Eliezer-Davidson/DS4DOCK/stl/faceplate/faceplate_full.stl

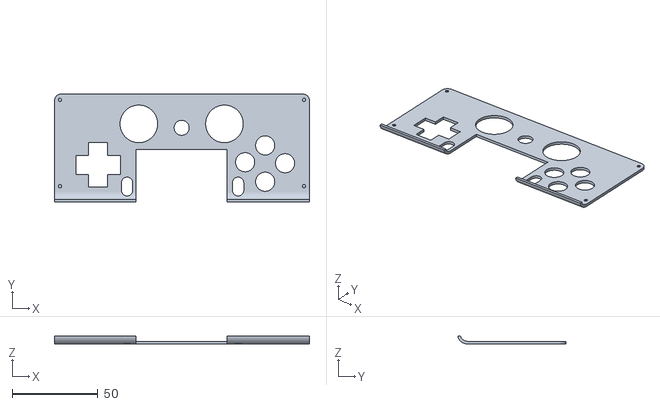
[picture p7: CAD file, 2026-10-22]
stl/faceplate/faceplate_full.stl
149.0 x 63.2 x 4.82
