Eliezer-Davidson/DS4DOCK/stl/caps/stick_cap_loose.stl

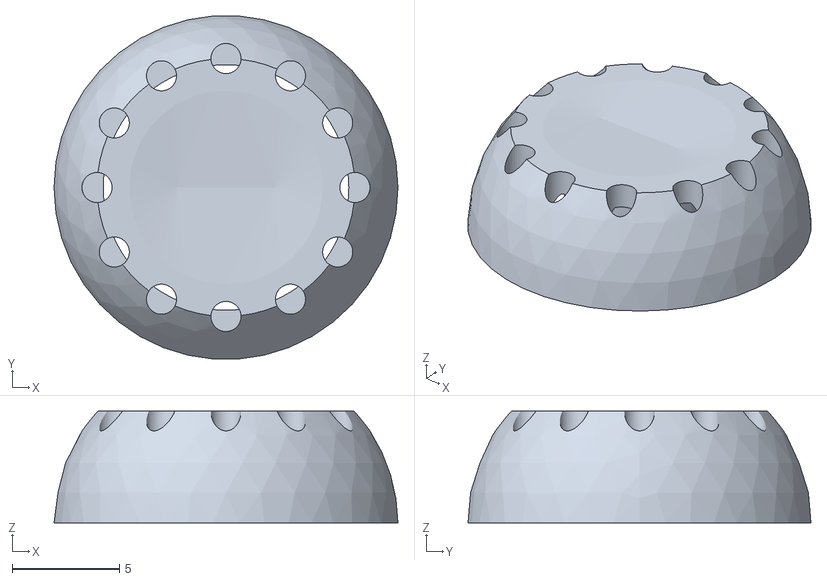
[picture p8: CAD file, 2026-10-22]
stl/caps/stick_cap_loose.stl
16.0 x 16.0 x 5.20
