Eliezer-Davidson/DS4DOCK/stl/cradle/cradle_std_nohook.stl

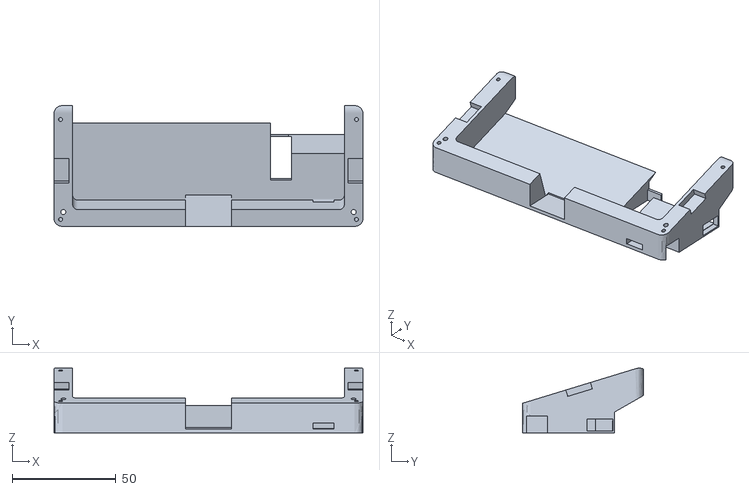
[picture p9: CAD file, 2026-10-22]
stl/cradle/cradle_std_nohook.stl
149.0 x 58.2 x 31.2
