Eliezer-Davidson/DS4DOCK/stl/extenders/right1_base_std_nohook.stl

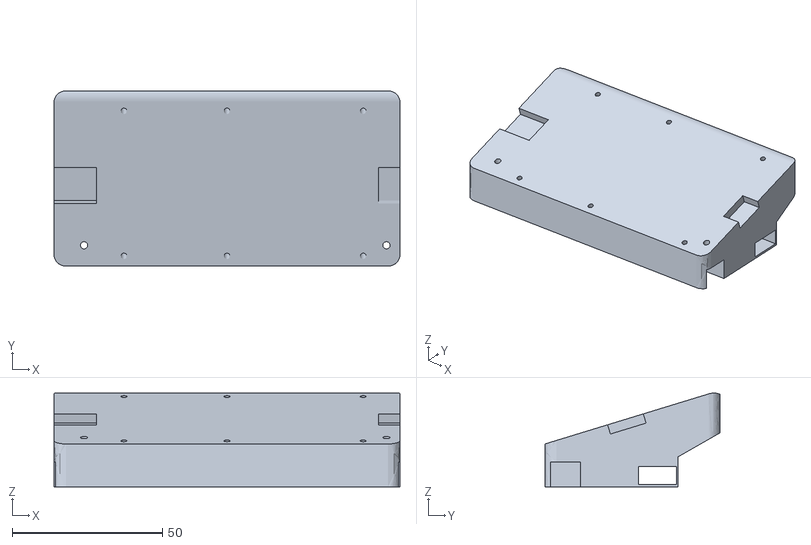
[picture p10: CAD file, 2026-10-22]
stl/extenders/right1_base_std_nohook.stl
115.0 x 58.2 x 31.2
