Eliezer-Davidson/DS4DOCK/stl/joint/topkey.stl

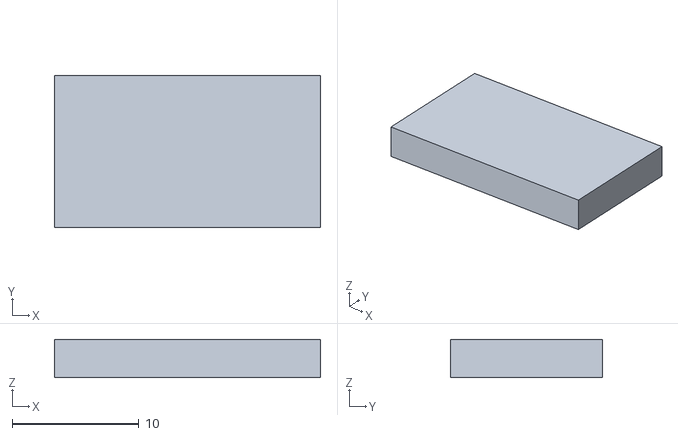
[picture p11: CAD file, 2026-10-22]
stl/joint/topkey.stl
21.0 x 12.0 x 3.00
