Eliezer-Davidson/DS4DOCK/stl/cradle/cradle_std_hook.stl

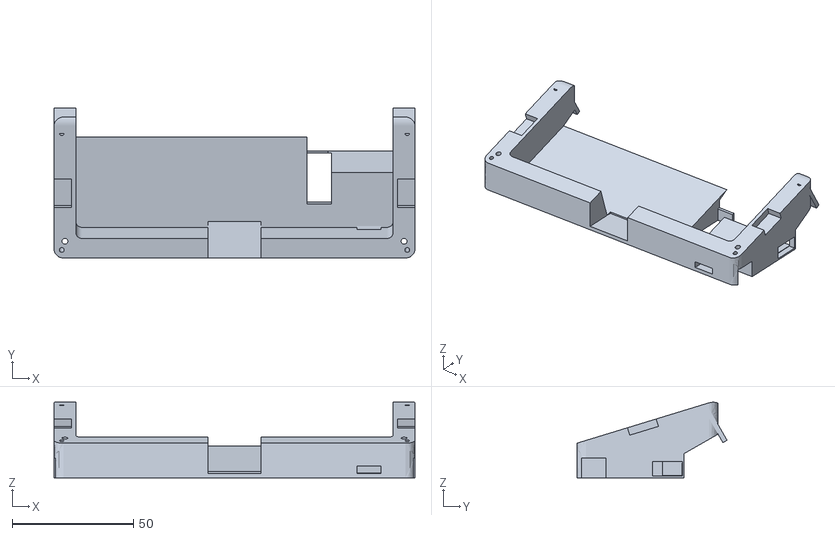
[picture p12: CAD file, 2026-10-22]
stl/cradle/cradle_std_hook.stl
149.0 x 62.0 x 31.2
