Eliezer-Davidson/DS4DOCK/stl/extenders/left_base_low_hook.stl

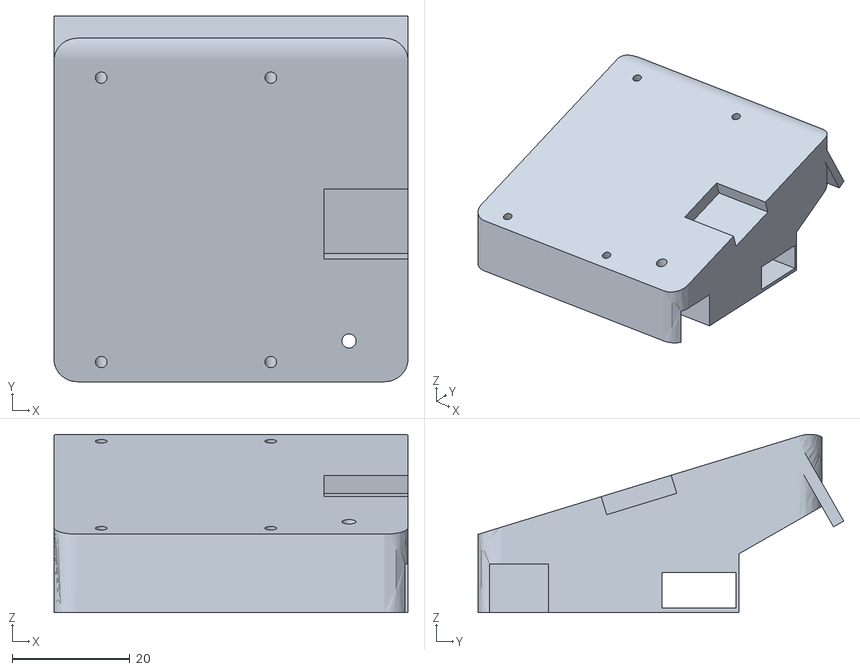
[picture p13: CAD file, 2026-10-22]
stl/extenders/left_base_low_hook.stl
60.0 x 62.0 x 30.2
