Eliezer-Davidson/DS4DOCK/stl/joint/spline.stl

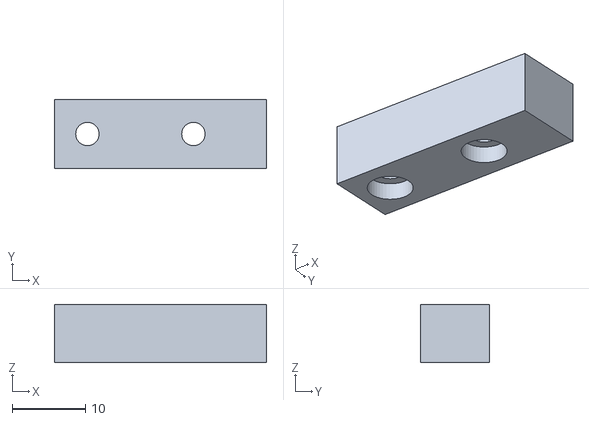
[picture p15: CAD file, 2026-10-22]
stl/joint/spline.stl
29.0 x 9.50 x 8.00
