Eliezer-Davidson/DS4DOCK/stl/cradle/cradle_low_hook.stl

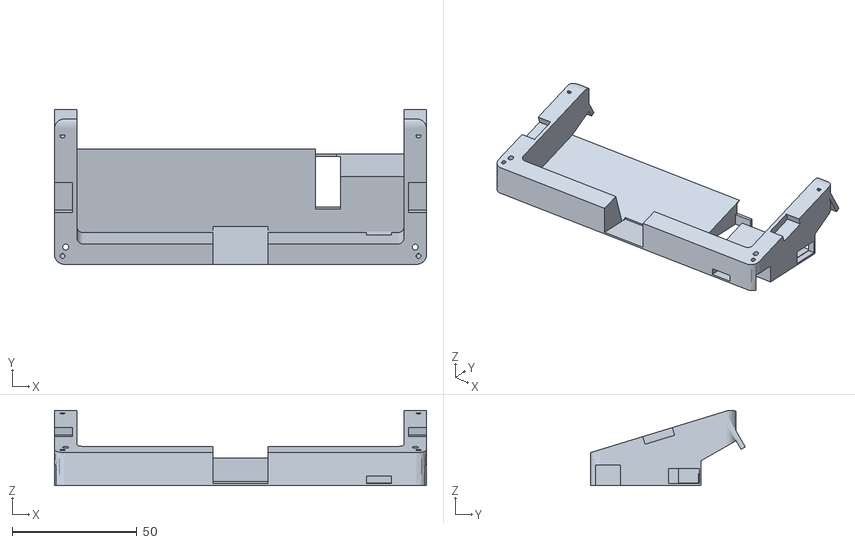
[picture p16: CAD file, 2026-10-22]
stl/cradle/cradle_low_hook.stl
149.0 x 62.0 x 30.2
