Eliezer-Davidson/DS4DOCK/stl/extenders/right2_base_std_nohook.stl

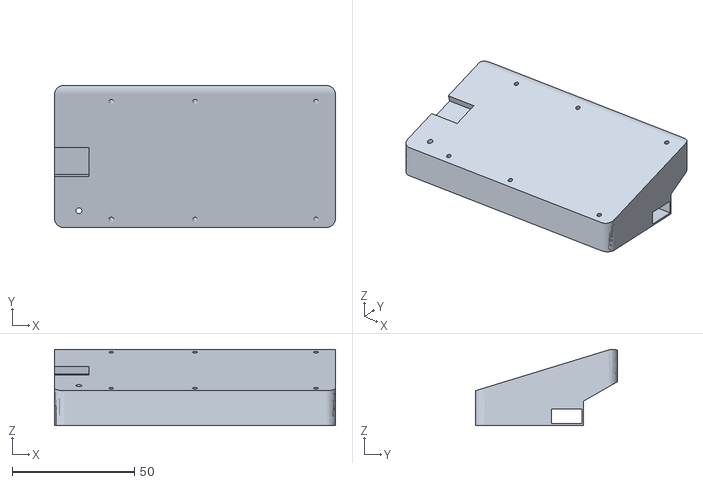
[picture p17: CAD file, 2026-10-22]
stl/extenders/right2_base_std_nohook.stl
115.0 x 58.2 x 31.2
