Eliezer-Davidson/DS4DOCK/stl/cradle/cradle_tall_hook.stl

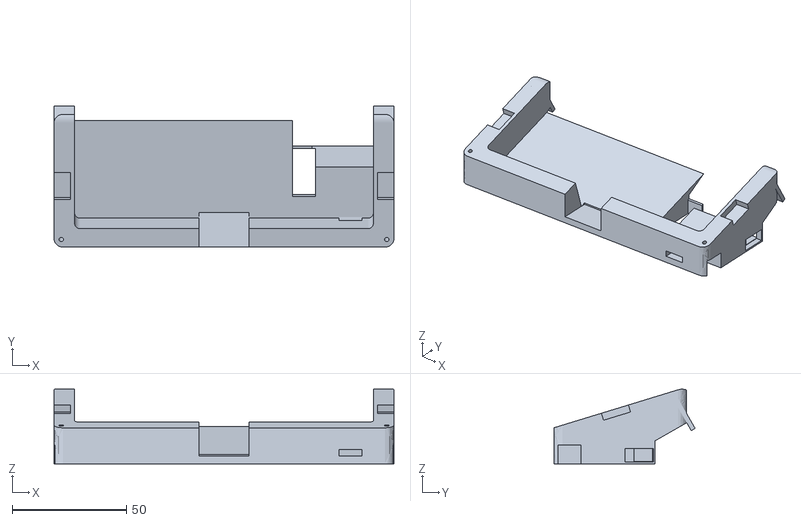
[picture p18: CAD file, 2026-10-22]
stl/cradle/cradle_tall_hook.stl
149.0 x 62.0 x 32.7
