Eliezer-Davidson/DS4DOCK/stl/extenders/left_base_low_nohook.stl

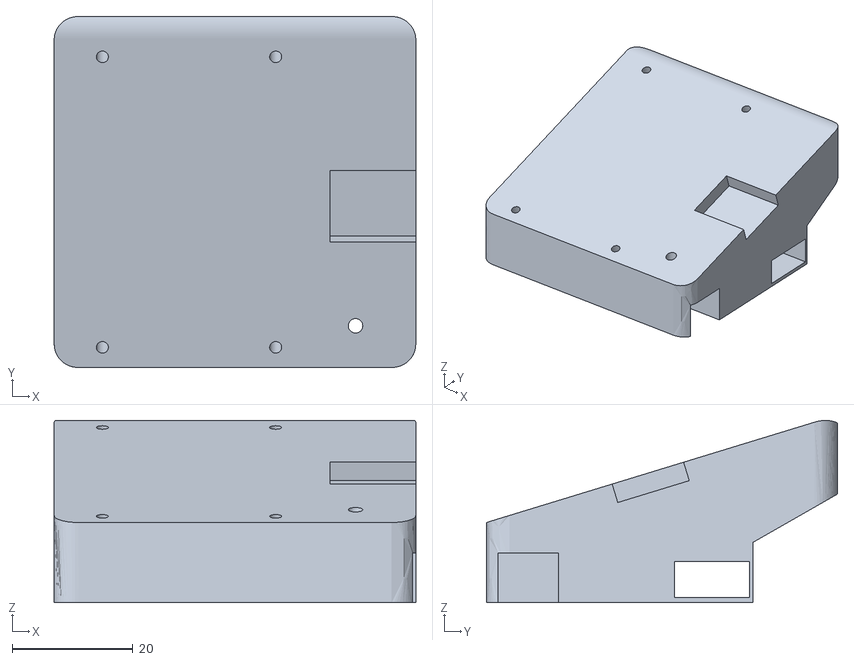
[picture p19: CAD file, 2026-10-22]
stl/extenders/left_base_low_nohook.stl
60.0 x 58.2 x 30.2
