Eliezer-Davidson/DS4DOCK/stl/cradle/cradle_low_nohook.stl

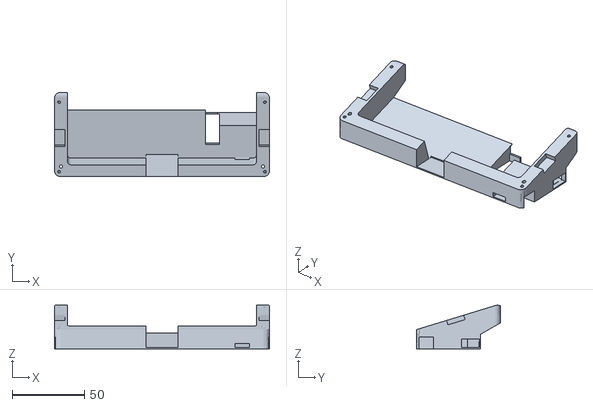
[picture p20: CAD file, 2026-10-22]
stl/cradle/cradle_low_nohook.stl
149.0 x 58.2 x 30.2
