Eliezer-Davidson/DS4DOCK/stl/extenders/right2_base_tall_hook.stl

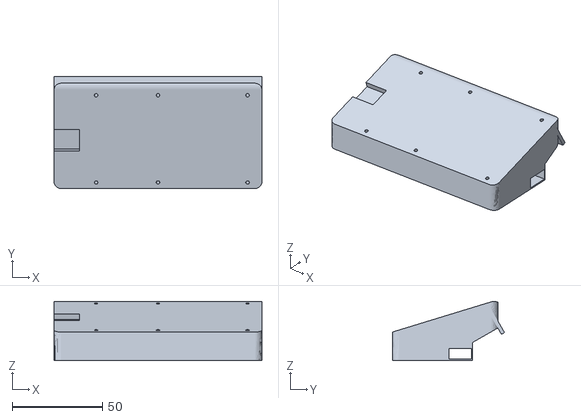
[picture p21: CAD file, 2026-10-22]
stl/extenders/right2_base_tall_hook.stl
115.0 x 62.0 x 32.7
