Eliezer-Davidson/DS4DOCK/stl/cradle/cradle_tall_nohook.stl

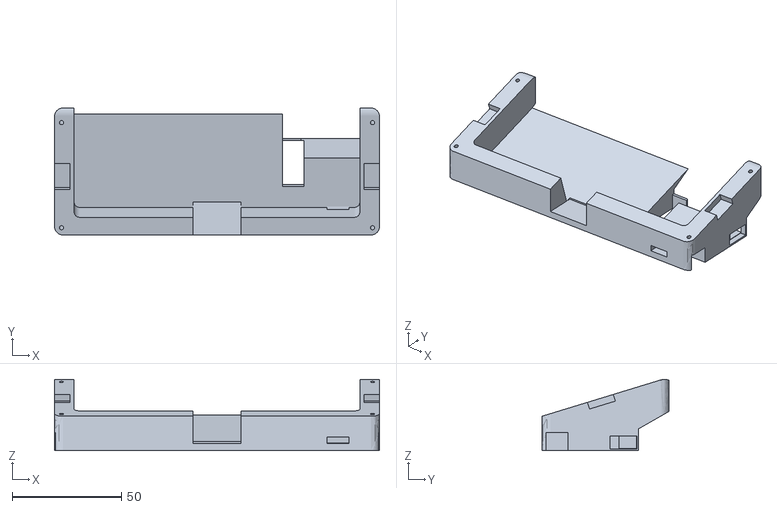
[picture p22: CAD file, 2026-10-22]
stl/cradle/cradle_tall_nohook.stl
149.0 x 58.2 x 32.7
