Eliezer-Davidson/DS4DOCK/stl/extenders/left_base_tall_nohook.stl

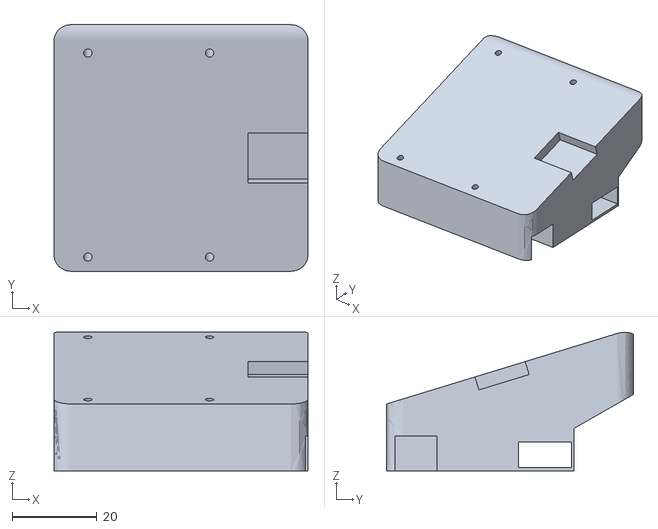
[picture p23: CAD file, 2026-10-22]
stl/extenders/left_base_tall_nohook.stl
60.0 x 58.2 x 32.7
