Eliezer-Davidson/DS4DOCK/stl/extenders/right1_base_low_hook.stl

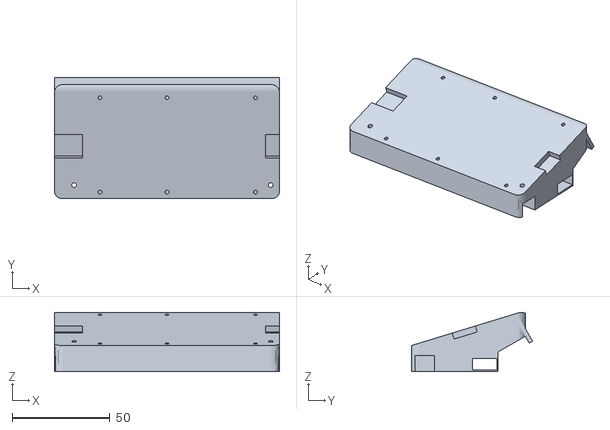
[picture p25: CAD file, 2026-10-22]
stl/extenders/right1_base_low_hook.stl
115.0 x 62.0 x 30.2
