Eliezer-Davidson/DS4DOCK/stl/extenders/left_base_tall_hook.stl

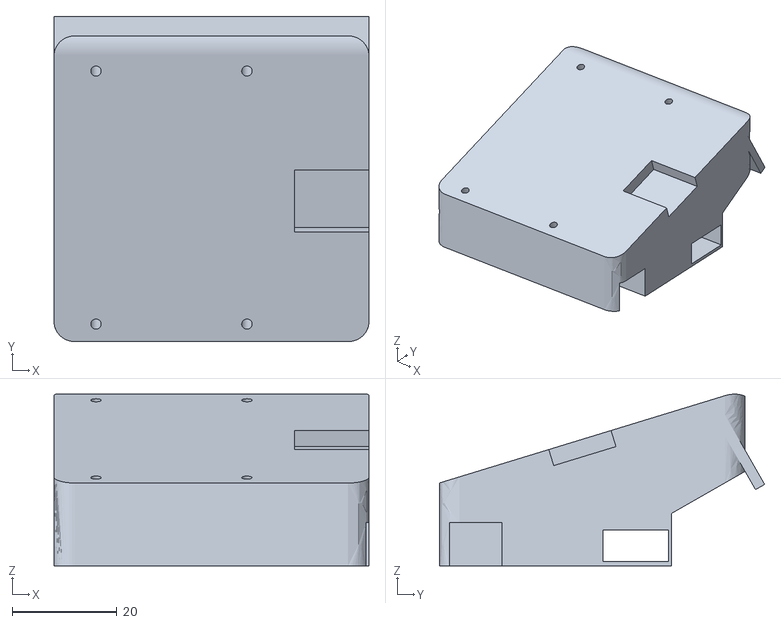
[picture p26: CAD file, 2026-10-22]
stl/extenders/left_base_tall_hook.stl
60.0 x 62.0 x 32.7
