Eliezer-Davidson/DS4DOCK/stl/extenders/left_plate.stl

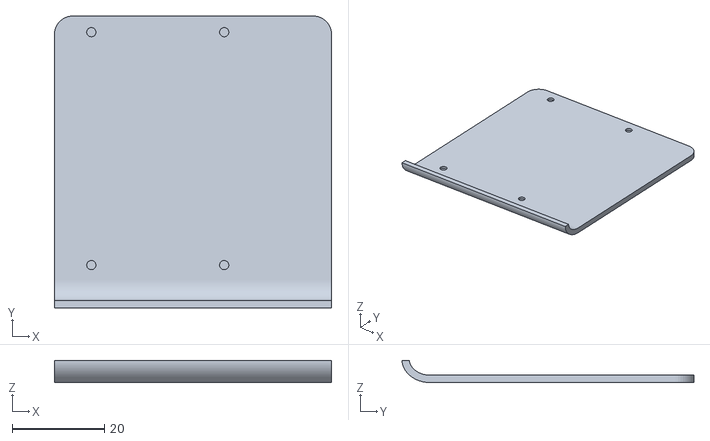
[picture p27: CAD file, 2026-10-22]
stl/extenders/left_plate.stl
60.0 x 63.2 x 4.82
