Eliezer-Davidson/DS4DOCK/stl/extenders/right2_base_low_nohook.stl

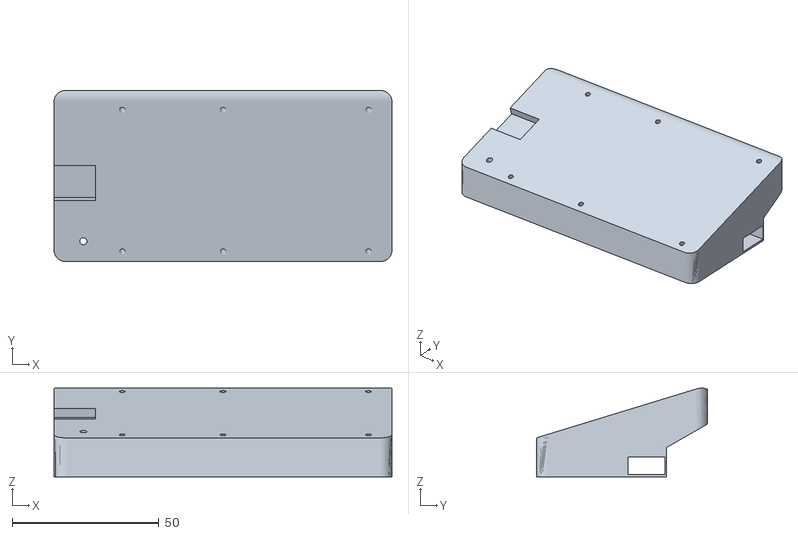
[picture p28: CAD file, 2026-10-22]
stl/extenders/right2_base_low_nohook.stl
115.0 x 58.2 x 30.2
