Eliezer-Davidson/DS4DOCK/stl/extenders/left_base_std_hook.stl

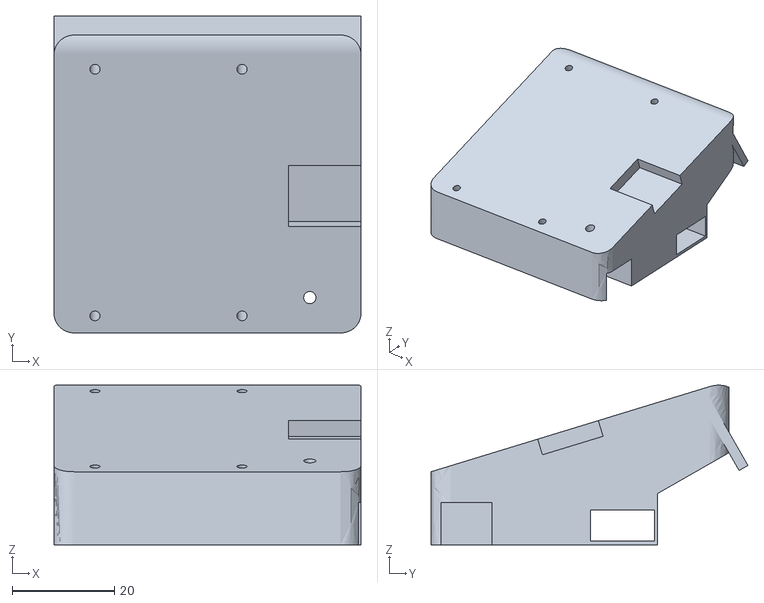
[picture p29: CAD file, 2026-10-22]
stl/extenders/left_base_std_hook.stl
60.0 x 62.0 x 31.2
