Eliezer-Davidson/DS4DOCK/stl/extenders/right1_base_std_hook.stl

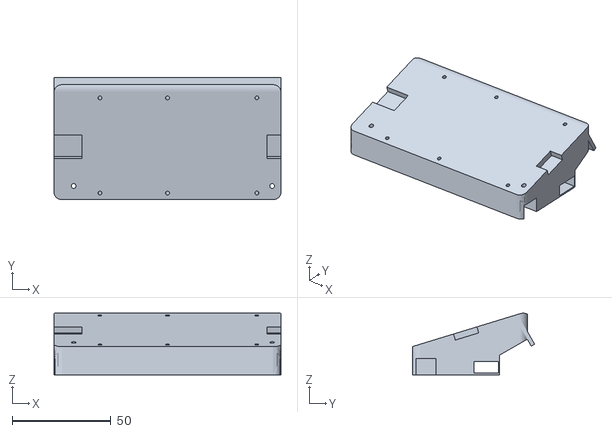
[picture p31: CAD file, 2026-10-22]
stl/extenders/right1_base_std_hook.stl
115.0 x 62.0 x 31.2
