Eliezer-Davidson/DS4DOCK/stl/extenders/right1_plate.stl

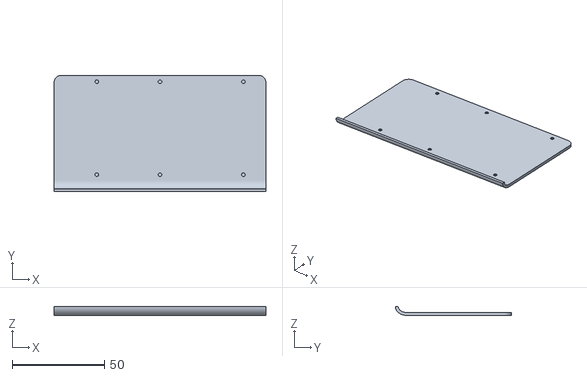
[picture p32: CAD file, 2026-10-22]
stl/extenders/right1_plate.stl
115.0 x 63.2 x 4.82
