Eliezer-Davidson/DS4DOCK/stl/extenders/right2_base_std_hook.stl

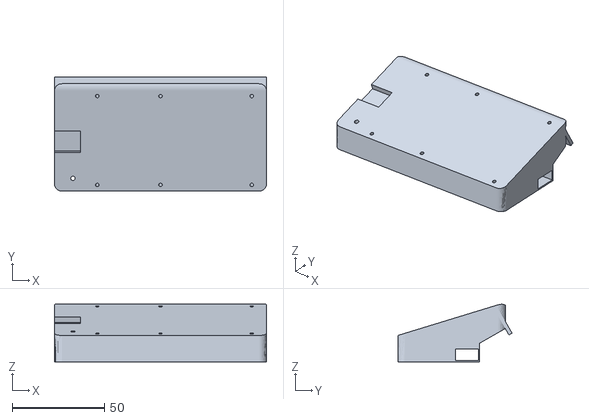
[picture p33: CAD file, 2026-10-22]
stl/extenders/right2_base_std_hook.stl
115.0 x 62.0 x 31.2
