Eliezer-Davidson/DS4DOCK/(list of files, cad)

Other CAD files:
stl/caps/stick_cap_tight.stl
stl/caps/stick_cap_nominal.stl
stl/extenders/right1_base_tall_hook.stl
stl/extenders/right2_base_tall_nohook.stl
stl/extenders/right1_base_low_nohook.stl
stl/extenders/right2_base_low_hook.stl
stl/extenders/right2_plate.stl
