Eliezer-Davidson/DS4DOCK/docs/CHANGELOG.md

# Changelog

Condensed from the project's measurement log and status notes. Dates are the dates the work was done. "Uploaded" means sent to the printer; "printed" means a part came off it; where a version was sliced but never sent, it says so.

## The frame

| Date | Version | What changed and why |
|---|---|---|
| 2026-09-22 | CAD v0 / v1 (OpenSCAD) | First parts from the public-domain CUH-ZCT2 scans: a 2 mm gauge ring of the pocket, a 2.5 mm face plate with the shell's hole table, a 164 x 78 x 36 mm wedge cradle with a 15 degree floor, two palm wings - 438 mm total, the K70's width. The same day the part was re-measured as a plain **130 x 55 mm rectangle** (the ruler reading of 135 was 5 mm off) and the scan silhouette was dropped for it. |
| 2026-09-24 | plate v1 fitted, plate v2 | The printed v1 plate on the part: stick holes ~3 mm too high (stick centres at y -0.5 from the PS button, not the scan's +2.5). v2 fixes that and stops at the top of the touchpad window (y 37.4) so the touchpad, Share and Options are open. Review of the v0 cradle finds the plate 3.8 mm up-slope of the board, vertical pilots missing the tilted holes and a dowel inside the USB bay. |
| 2026-09-27 | build123d port; plate v3, cradle v1 | The CAD moves to build123d with the two frames (W and P) and the top face built in P. Plate 1.6 mm (was 2.5), d-pad opening 26.0 x 11.0 per bar. Cradle v1: flat bottom, 15 degree top, 149 x 71.0 x 33.8 mm, `stack_h` 14 assumed. |
| 2026-10-02 | cradle v2 | As low as possible: floor 1.6 mm (was 3.0), no wall on the keyboard side (the pocket runs out open), a full-length channel in the floor for the charging-board connector so the board lies flush. 149 x 57.9 x 28.9 mm, 80 cm³ (v1: 140). |
| 2026-10-03 | cradle v3, plate v4 | Tilt 10 degrees for a lower base; walls 3 mm lower (`stack_h` 11); finger notch becomes a 22 mm square slot; the channel moves to x 30..40 and joins a charging-board bay under the floor with a port hole in the right face. 149 x 59.0 x 21.9 mm. Plate v4 runs to the cradle's end, Share/Options 2 mm lower and enclosed, **d-pad and face-button holes filled** - the plate is a palm rest now - and no screw holes. |
| 2026-10-04 | cradle v4, plates v5 and v6 | Walls 1 mm taller (`stack_h` 12). Plate v5 closes the PS hole and makes Share/Options stadium slots (6.0 x 10.0). Plate v6: slots 7.0 x 11.0, stick holes 22 mm (`stick_travel` 2.6), screw holes back as 2 mm through + 4 mm head recess. Cradle v4 + plate v6 uploaded (PLA). |
| 2026-10-05 | cradle v5, plate v7 | Walls 2 mm taller (`stack_h` 14); channel exit widened to x 30..45; the channel's underside opening moved 10 mm toward the keyboard; cradle 1 mm deeper so the raised slots keep 1.3 mm of plate above them. Plate v7: stick holes 2 mm lower (y -2.5), slots 6.6 x 11.0 at y 34.1, touchpad opening bottom at y 12.6. |
| 2026-10-05 | cradle v6 | Pilots 2.0 mm to match the plate's screws. **Keyboard-lip undercut** along the whole keyboard side: a right trapezoid 14 mm along the desk, 10 mm tall inside, 18 mm at the end face (29.7 degrees), matched to the K70's lip as traced on paper. The side rims float above it as arms. Base on the desk 149 x 46 mm. |
| 2026-10-05 | cradle v7 | **PETG only from now on.** The notch the undercut leaves in the right wall becomes the cable exit, at least 6 mm wide. First PETG slice: tree supports from the plate only under the floating arms, 1 h 26 m, 33 g. The dowel holes, dropped at first because PETG tree supports filled them, come back the same day as teardrops that print with nothing inside; re-sliced, 1 h 30 m, 34 g. |
| 2026-10-06 | cradle v8, plate v8 | Tilt 14.5 degrees with the floor lowered to 1.0 mm; LED notch for the port board's LED end (10 x 3 mm, floor level, wall facing the user); rim rounded under the plate's lip. Plate v8: Options 1 mm right; the keyboard end **curves down** like the touchpad's top edge (R 8 through ~73 degrees); prints upside down with a 0.2 mm skin bridging each screw hole. |
| 2026-10-06 | cradle v9, plate v9 | **The spiral lip:** radius shrinking linearly with turn angle, 8 mm to 3 mm through a full 90 degrees, from a closed-form integral; tip 6.2 mm past y 37, 4.8 mm below the top face. Cradle tilt 17 degrees; LED notch 5 mm left; the rim's cut under the lip built from the lip's underside points. Plate-on-cradle intersection 0.000 mm³. Cradle 1 h 27 m, 33.2 g; plate 33 m 43 s, 13.4 g. **Plate v9 is the face plate that has been printed and is in use; nothing since has changed it.** |
| 2026-10-07 | extenders v1, stick caps v1 | Cradle v9 + plate v9 confirmed right on the part. Solid wrist rests either side (left 60, right 80 mm) with the dock's full profile, joined by loose 5.7 x 14 mm pins; a cable channel through the right one. Finding: printing them **on end** cuts support from 700-2400 s to 23-25 s. Stick caps: 3 x 3.5 mm socket, 4 mm deep, printed at three clearances to find the one that grips. A combined extension plate (both extenders, 2 caps, 4 pins; 2 h 19 m, 63.3 g) uploaded. |
| 2026-10-08 | cradle v10, extenders v2 | `floor_h` 2.0: 1 mm taller from the base, which raises cradle and extenders together and leaves the plate alone. **Dowel pins retired** for a loose spline + two M3 screws in the solid front wall. The cable port runs on through the extenders, sized for a micro-USB plug. **The keyboard hook:** the arm above the undercut carries on 2 mm and drops 4 mm behind the lip. Extenders become left 60 + right 230 = **439 mm**, the right one in two 115 mm halves joined like the cradle. |
| 2026-10-12 | **v11** | After printing the v10 test plate and the v2 extender plate, six changes: (1) **hook on the side walls only**, 9 mm each - the full-width bar fouled the board, which overhangs the end face by 3.6 mm; (2) pocket 1 mm deeper (`stack_h` 15) because the plate bowed upward when screwed down; (3) **extenders v3 = base + their own face plate**, so the top is textured and flush by construction; (4) a **second connector per seam**, a 21 x 12 x 3 mm top key under the plate, 17 mm above the spline; (5) smaller joint screws (clearance 3.2, counterbore 5.6 x 2.2, pilot 2.4); (6) caps v3, 5.2 mm tall and 12 mm wide (the undated v2 between had already turned the cap into a bell with a skirt). Also the undercut's extrude reach 200 to 600 and the lip solid 400 to 800, after the outermost piece came out without its undercut. Sliced as three plates - 21 bodies, 8 h 14 m, 205 g - and **uploaded 2026-10-12**: p1 cradle v11 + left base + left plate + 4 top keys (149 x 129 mm, 2 h 53, 70 g); p2 right1 base + plate + 4 splines + 3 caps (148 x 129, 2 h 50, 70 g); p3 right2 base + plate + 3 caps (135 x 129, 2 h 30, 64 g). |
| 2026-10-21 | **v11 printed and assembled** | All three plates had come off the printer; the set was assembled with plate v9 on the cradle and put in use in front of the keyboard - the photograph in the [README](../README.md). No fit report has been written. |
| 2026-10-21 | repository | The parameter file gains `plate_style` (`palm` / `full`) and the pre-built STL matrix (`cad/variants.py` into `stl/`: three heights x hook / no hook, two face plates, joint keys, three cap fits); `cad/checks.py` as the geometric check suite; `cad/render.py` for the images in `docs/images/`. None of the new variants has been printed. |
| 2026-10-22 | check-suite finding | `cad/checks.py` reports that the cradle's two front plate-screw pilots (x +-71.3, 3.2 mm from each seam) open into the spline seat after about 7.4 of their 10 mm, beside the spline's own M3 pilot. Recorded as two `KNOWN` rows rather than failures (`--strict` fails them): those two plate screws must be 2 x 4 mm. Moving the front screw row inboard of x +-65 would fix it but changes two holes in plate v9, which is printed - undecided. Not yet checked on the part. |

What has physically been printed, as of 2026-10-21: plate v1 (the 2026-09-24 fit), cradle v10, plate v9, the one-piece v2 extenders that reached the printer (the left one, and the outermost right one, which came off without its keyboard undercut - the extrude-reach bug), the v10 test plate, and the complete v11 set, assembled on 2026-10-21 and in use. Everything else in `stl/` is generated and unprinted.

## The mapper

| Date | Milestone | Notes |
|---|---|---|
| 2026-09-22 | **Phase 1 - hardware checklist passed** | Every input readable through the script's own functions on the bare board: 250 Hz with 0 gaps in 20 000 samples, sticks and triggers 0..255, touchpad two contacts + click, gyro / accelerometer, light bar 14 writes 0 failures, rumble bytes 0. L2/R2 found resting at 255 without the rear shell. Read + parse loop 5.3 % of one core. |
| 2026-09-22 | **Phase 2 - injection and feel** | Windows injection moves from `pynput` to `SendInput` through `ctypes` (relative motion, 1/120-notch wheel, scan codes). Touch motion tracked per contact id; touch sessions with tap detection; two-finger scroll; left-stick flicks with hysteresis; auto-repeat at the system rate; `tune.json` re-read live. Live-tested the same day; the default values stayed. Linux `evdev`/`uinput` backend written, untested on hardware. |
| 2026-10-05 | **Autostart (Windows)** | `ds4_autostart.pyw`: a hidden watcher that starts the mapper when the pad is present, restarts it when the pad returns, backs off after a quick crash, never doubles a hand-started mapper, and pauses on an `autostart.off` file. |
| 2026-10-05 to 2026-10-20 | **Pad dead: USB port board** | Around 2026-10-05 the pad stopped enumerating: no device, no error, no Kernel-PnP event on plug-in. Diagnosed as the micro-USB port board (JDS-055), the one part on its own ribbon; a new board and ribbon went in on 2026-10-20 (about $10, no soldering) and the watcher started the mapper by itself 2 s after it enumerated. See [HARDWARE.md](HARDWARE.md#the-usb-port-board-swap). |
| 2026-10-21 | **Control map v2** | Designed around the five buttons that physically exist (see [CONTROLS.md](CONTROLS.md)). Momentary **Fn** on L3 with Esc on a clean tap; tap-vs-hold on Share / Options with the modifier engaging at `hold_s`; the right stick as arrow keys with deflection-scaled repeat (`rstick_mode` keeps the old cursor behaviour); **key sequences** (`ctrl+k ctrl+left`); Fn + pad click to suspend; the light bar rewritten as a priority table with idle off, every colour steady; the attention file. Two bugs caught during the build: activity for the blue light could not come from raw stick values, and `last_input` was compared across two different clocks. Self-test green. |
| 2026-10-21 | **Repository** | The control map moves out of the code into `mapping.json` (loader, validator, `--map`, `--dump-map`; the in-code tables remain the defaults and round-trip). The Claude-specific state becomes the generic **attention** state (`attention_state.txt`, `--attention-file`), with Claude Code hooks as the documented example. `tools/mapping_editor.py` and `tools/render_map.py` are added; CI runs the self-tests on Ubuntu and Windows. |
| 2026-10-26 | **Screen off on Fn + pad click** | I wanted a button that blanks the screen while everything keeps running, so the new `screen_off` action took suspend's place on that chord. The first design switched the monitors off with a broadcast `SC_MONITORPOWER`; research before it ever ran turned up reports that on Modern Standby laptops Windows treats that like the power button and starts a standby that cancels every keep-awake request, so it became a **black curtain**: a topmost window over each monitor that never takes the focus, with `ES_DISPLAY_REQUIRED` held so Windows' screen and sleep timers stay quiet (`screen_off_keep_awake`, a new tune key; let go on battery below 20 %). Held keys are let go at once and the curtain goes up 0.4 s later; while it is dark the pad injects nothing and the light bar is off except for the attention orange. A key, the mouse, a touch or the chord again brings it back. The first live test lifted the curtain by itself within 1.5 s: the dock's floating **R2** moves Windows' idle clock several times a second, so the curtain now watches the keyboard and the mouse through Raw Input instead ([HARDWARE.md](HARDWARE.md#l2--r2-without-triggers)), and a click, a wheel turn, a touch or a pen landing on it counts too; it keeps a click or a tap whole, lifting only once the button or the finger is up again (at most 2 s later), so none of it reaches the app beneath. Its own thread also lifts it if the mapper stops checking on it for 5 s. A review found that a display change while it was up briefly left it with no windows, which the mapper took for a lift; a display change now covers the monitors anew before the old windows go. `suspend` stays as an action a map can bind but is no longer on any button by default; going into and out of either quiet mode now takes the pad's current state as the new reference, so nothing jumps. Windows only: on Linux and with `--no-inject` the chord still lets go of held keys and the pad goes quiet for those 0.4 s, and then the mapper carries on as normal. The self-test covers the mapper's side, and the curtain's own logic against a stand-in for Windows, and passes; the curtain was raised for real as a 60 x 60 px square and passed (up in under 10 ms, held while the idle clock moved, rebuilt after a display-change message, lifted by an injected mouse event, by a lost heartbeat and on request); full-screen, from the real chord, it has **not been tried yet**. A mapper started before this change refuses the new `mapping.json` (it does not know `screen_off`) and keeps its old map, so the chord goes on suspending until the mapper is restarted. |

Still open on the mapper: reconnect inside the mapper after an unplug (the watcher restarts it instead); re-releasing a key whose key-up Windows refused; tap-and-drag, palm rejection and per-app profiles; `cursor_centre` is a no-op on Linux (relative `uinput` device); over Bluetooth on Windows the padded `0x01` report is mistaken for USB, so full reports are never requested; screen off is Windows-only and has been raised for real only as a test square - the real chord at full screen, the real keyboard, mouse and touchpad or a touch or a pen on the screen bringing it back, and a long dark spell with a download and audio running, are still to be tried.
