Eliezer-Davidson/DS4DOCK/(commit log)

2026-10-22 DS4 dock: mapper, mapping editor, parametric frame, docs
    A DualShock 4 cut down to its board and rebuilt as a wrist rest in
    front of the keyboard: touchpad pointer, two sticks, five buttons and
    a momentary Fn layer, with the light bar as a status light.
    - ds4_dock.py: one-file host-side mapper (USB HID at 250 Hz, SendInput
    / uinput injection, control map v2 loaded from mapping.json, live
    reload, attention-file light state, hardware-free --selftest)
    - ds4_autostart.pyw: Windows logon watcher that starts the mapper when
    the pad appears and restarts it after USB dropouts
    - tools/: tkinter mapping editor drawn on the dock's face plate to
    scale, and the SVG map renderer it shares its geo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
    [cradle_low_hook.stl, cradle_low_nohook.stl, cradle_std_hook.stl, cradle_std_nohook.stl, cradle_tall_hook.stl, cradle_tall_nohook.stl, faceplate_full.stl, faceplate_palm.stl]
2026-10-26 Screen off on Fn + pad click: a black curtain woken by Raw Input
    Fn + pad click (the chord that was suspend) now blacks out every screen
    while everything keeps running. It is a black, topmost, non-activating
    window per monitor on a thread of its own, with ES_DISPLAY_REQUIRED held,
    not a monitor-off: on Modern Standby laptops an SC_MONITORPOWER monitor-off
    has been reported to start a standby that cancels every keep-awake
    request. suspend stays as an action a map can bind.
    The curtain watches the keyboard and the mouse itself, through Raw Input
    (RIDEV_INPUTSINK), plus fingers, pens, clicks and wheel turns landing on
    it. It keeps a click or a tap whole, lifting only once the button or the
    con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
